codestorm1/mutebox_hat_audio_in/mutebox_hat_audio_in-JLCPCB Assembly Order.xls

JLCPCB BOM Tool - BOM Matching
BOM name：mutebox_hat_audio_in-JLCPCB Assembly Order.xlsx |  |  | Download Time：2026-02-12 05:37:34 |  |  |  | * Our matching results are updated in real-time, but stock and prices may change. If it's been over 24 hours, please re-match before placing your order.
PCB Assembled Qty：5 |  |  | Est. Total Price：35.0635
Your BOM |  |  |  |  | Matched Parts |  |  |  |  |  |  | Order Information
Top Designator | Bottom Designator | Comment | Footprint | JLCPCB Part # | Matches | Part # | Manufacturer | Footprint | Description | Category | Warning | JLCPCB Part # | Product link | Lib Type | Qty | Source | Total Price ($)
C2,C3,C12 |  | 100nF | Capacitor_SMD:C_0805_2012Metric_Pad1.18x1.45mm_HandSolder |  | Select by System | CC0603KRX7R9BB104 | YAGEO | 0603 | 100nF 50V X7R ±10% 0603 Multilayer Ceramic Capacitors MLCC - SMD/SMT ROHS | Multilayer Ceramic Capacitors MLCC - SMD/SMT |  | C14663 | https://jlcpcb.com/partdetail/YAGEO-CC0603KRX7R9BB104/C14663 | Basic | 15 | 15 JLCPCB | 0.039
C4 |  | 68nF | Capacitor_SMD:C_0805_2012Metric_Pad1.18x1.45mm_HandSolder |  | Select by System | CC0805KRX7R9BB683 | YAGEO | 0805 | 50V 68nF X7R ±10% 0805 Multilayer Ceramic Capacitors MLCC - SMD/SMT ROHS | Multilayer Ceramic Capacitors MLCC - SMD/SMT |  | C107159 | https://jlcpcb.com/partdetail/YAGEO-CC0805KRX7R9BB683/C107159 | Extended | 20 | 20 JLCPCB | 0.15
C5 |  | 4.7nF | Capacitor_SMD:C_0805_2012Metric_Pad1.18x1.45mm_HandSolder |  | Select by System | CC0805KRX7R9BB472 | YAGEO | 0805 | 4.7nF 50V X7R ±10% 0805 Multilayer Ceramic Capacitors MLCC - SMD/SMT ROHS | Multilayer Ceramic Capacitors MLCC - SMD/SMT |  | C107153 | https://jlcpcb.com/partdetail/YAGEO-CC0805KRX7R9BB472/C107153 | Extended | 20 | 20 JLCPCB | 0.12
C8,C9 |  | 1uF | Capacitor_SMD:C_0805_2012Metric_Pad1.18x1.45mm_HandSolder |  | Select by System | CL21B105KBFNNNE | Samsung Electro-Mechanics | 0805 | 1uF 50V X7R ±10% 0805 Multilayer Ceramic Capacitors MLCC - SMD/SMT ROHS | Multilayer Ceramic Capacitors MLCC - SMD/SMT |  | C28323 | https://jlcpcb.com/partdetail/29074-CL21B105KBFNNNE/C28323 | Basic | 10 | 10 JLCPCB | 0.099
C10 |  | 10uF | Capacitor_SMD:C_0805_2012Metric_Pad1.18x1.45mm_HandSolder |  | Select by System | CL21A106KAYNNNE | Samsung Electro-Mechanics | 0805 | 10uF 25V X5R ±10% 0805 Multilayer Ceramic Capacitors MLCC - SMD/SMT ROHS | Multilayer Ceramic Capacitors MLCC - SMD/SMT |  | C15850 | https://jlcpcb.com/partdetail/16532-CL21A106KAYNNNE/C15850 | Basic | 5 | 5 JLCPCB | 0.079
FB1 |  | FerriteBead | Inductor_SMD:L_0805_2012Metric_Pad1.05x1.20mm_HandSolder |  | Select by System | BLM21PG221SN1D | Murata Electronics | 0805 | 1 220Ω@100MHz 2A 45mΩ ±25% 0805 Ferrite Beads ROHS | Ferrite Beads |  | C85840 | https://jlcpcb.com/partdetail/MurataElectronics-BLM21PG221SN1D/C85840 | Extended | 20 | 20 JLCPCB | 0.332
R3,R4,R5,R6 |  | 10k | Resistor_SMD:R_0805_2012Metric_Pad1.20x1.40mm_HandSolder |  | Unconfirmed | RC0805FR-0710KL | YAGEO | 0805 | -55℃~+155℃ 10kΩ 125mW 150V Thick Film Resistor ±1% ±100ppm/℃ 0805 Chip Resistor - Surface Mount ROHS | Chip Resistor - Surface Mount | 1.Multiple lines in the BOM have been matched to the same part. Please check if the matching is correct. ; | C84376 | https://jlcpcb.com/partdetail/YAGEO-RC0805FR0710KL/C84376 | Extended | 35 | 35 JLCPCB | 0.0805
R7 |  | 10K | Resistor_SMD:R_0805_2012Metric_Pad1.20x1.40mm_HandSolder |  | Unconfirmed | RC0805FR-0710KL | YAGEO | 0805 | -55℃~+155℃ 10kΩ 125mW 150V Thick Film Resistor ±1% ±100ppm/℃ 0805 Chip Resistor - Surface Mount ROHS | Chip Resistor - Surface Mount | 1.Multiple lines in the BOM have been matched to the same part. Please check if the matching is correct. ; | C84376 | https://jlcpcb.com/partdetail/YAGEO-RC0805FR0710KL/C84376 | Extended | 35 | 35 JLCPCB | 0.0805
R8,R11,R20,R21 |  | 100k | Resistor_SMD:R_0805_2012Metric_Pad1.20x1.40mm_HandSolder |  | Unconfirmed | 0805W8F1003T5E | UNI-ROYAL(Uniroyal Elec) | 0805 | -55℃~+155℃ 100kΩ 125mW 150V Thick Film Resistor ±1% ±100ppm/℃ 0805 Chip Resistor - Surface Mount ROHS | Chip Resistor - Surface Mount | 1.The comment (0805W8F1003T5E) of this part does not match the one (100k) provided in your BOM. Please confirm; | C149504 | https://jlcpcb.com/partdetail/160838-0805W8F1003T5E/C149504 | Basic | 20 | 20 JLCPCB | 0.04
R9,R10 |  | 4.7k | Resistor_SMD:R_0805_2012Metric_Pad1.20x1.40mm_HandSolder |  | Select by System | 0805W8F4701T5E | UNI-ROYAL(Uniroyal Elec) | 0805 | -55℃~+155℃ 125mW 150V 4.7kΩ Thick Film Resistor ±1% ±100ppm/℃ 0805 Chip Resistor - Surface Mount ROHS | Chip Resistor - Surface Mount |  | C17673 | https://jlcpcb.com/partdetail/18361-0805W8F4701T5E/C17673 | Basic | 10 | 10 JLCPCB | 0.019
R12 |  | 680 | Resistor_SMD:R_0805_2012Metric_Pad1.20x1.40mm_HandSolder |  | Select by System | 680 | Keystone | - | - Ring Terminal ROHS | Cold-Pressed Terminals |  | C238151 | https://jlcpcb.com/partdetail/Keystone-680/C238151 | Extended | 0 | 0 JLCPCB | 0
R14 |  | 33 | Resistor_SMD:R_0805_2012Metric_Pad1.20x1.40mm_HandSolder |  | Select by System | RC0402FR-0733RL | YAGEO | 0402 | -55℃~+155℃ 33Ω 50V 62.5mW Thick Film Resistor ±1% ±100ppm/℃ 0402 Chip Resistor - Surface Mount ROHS | Chip Resistor - Surface Mount |  | C138002 | https://jlcpcb.com/partdetail/YAGEO-RC0402FR0733RL/C138002 | Extended | 20 | 20 JLCPCB | 0.016
U2 |  | 74LVC157 | Package_SO:SOIC-16_3.9x9.9mm_P1.27mm |  | Select by System | SN74LVC157ADR | Texas Instruments | SOIC-16-150mil | -40℃~+85℃ 24mA 24mA 2V~3.6V 40uA 5.2ns@3.3V,50pF Single Supply SOIC-16-150mil Signal Switches, Multiplexers, Decoders ROHS | Signal Switches, Multiplexers, Decoders |  | C7664 | https://jlcpcb.com/partdetail/TexasInstruments-SN74LVC157ADR/C7664 | Extended | 5 | 5 JLCPCB | 0.83
U5 |  | DIR9001PW | DIR9001_newfoot:PW28-M |  | Select by System | DIR9001PWR | Texas Instruments | TSSOP-28 | -40℃~+85℃ 2.7V~3.6V 28kHz~108kHz I2S Receiver TSSOP-28 Audio Interface ICs ROHS | Audio Interface ICs |  | C96215 | https://jlcpcb.com/partdetail/TexasInstruments-DIR9001PWR/C96215 | Extended | 5 | 5 JLCPCB | 6.876
Y3 |  | XO32 | Oscillator:Oscillator_SMD_EuroQuartz_XO32-4Pin_3.2x2.5mm |  | Select by System | ASE-24.576MHZ-LC-T | Abracon LLC | SMD3225-4P | -40℃~+85℃ 13mA 24.576MHz 3.3V ±50ppm SMD3225-4P Crystal Oscillators ROHS | Global Sourcing Parts |  | C6159263 | https://jlcpcb.com/partdetail/AbraconLLC-ASE_24_576MHZ_LCT/C6159263 | Extended | 9 | 9 JLCPCB | 26.3025
D1,D2 |  | APA102 | LED_SMD:LED_RGB_5050-6 |  | Select by System | APA102-2020 SuperLED | Led-Color | SMD-6P,2x2mm | SMD-6P,2x2mm RGB LEDs ROHS | Others |  | C22439302 | https://jlcpcb.com/partdetail/LedColor-APA102_2020SuperLED/C22439302 | Extended | 14 | 0 JLCPCB | 0
U3 |  | PCM1862DBT | Package_SO:TSSOP-30_6.1x9.7mm_P0.65mm |  | Select by System | PCM1862DBT | Texas Instruments | TSSOP-30 | -40℃~+125℃ 103dB 1MHz~50MHz 2 2.1V 24 3.3V 32kHz 353uA Built-in External、Built-in SPI、I2C Support Yes TSSOP-30 Analog to Digital Converters (ADC) ROHS | Analog To Digital Converters (ADCs) |  | C206108 | https://jlcpcb.com/partdetail/TexasInstruments-PCM1862DBT/C206108 | Extended | 5 | 0 JLCPCB | 0
