codestorm1/mutebox_hat_audio_in/mutebox_hat_audio_in.kicad_pcb

## KiCad design mutebox_hat_audio_in.kicad_pcb (2026-03-16)

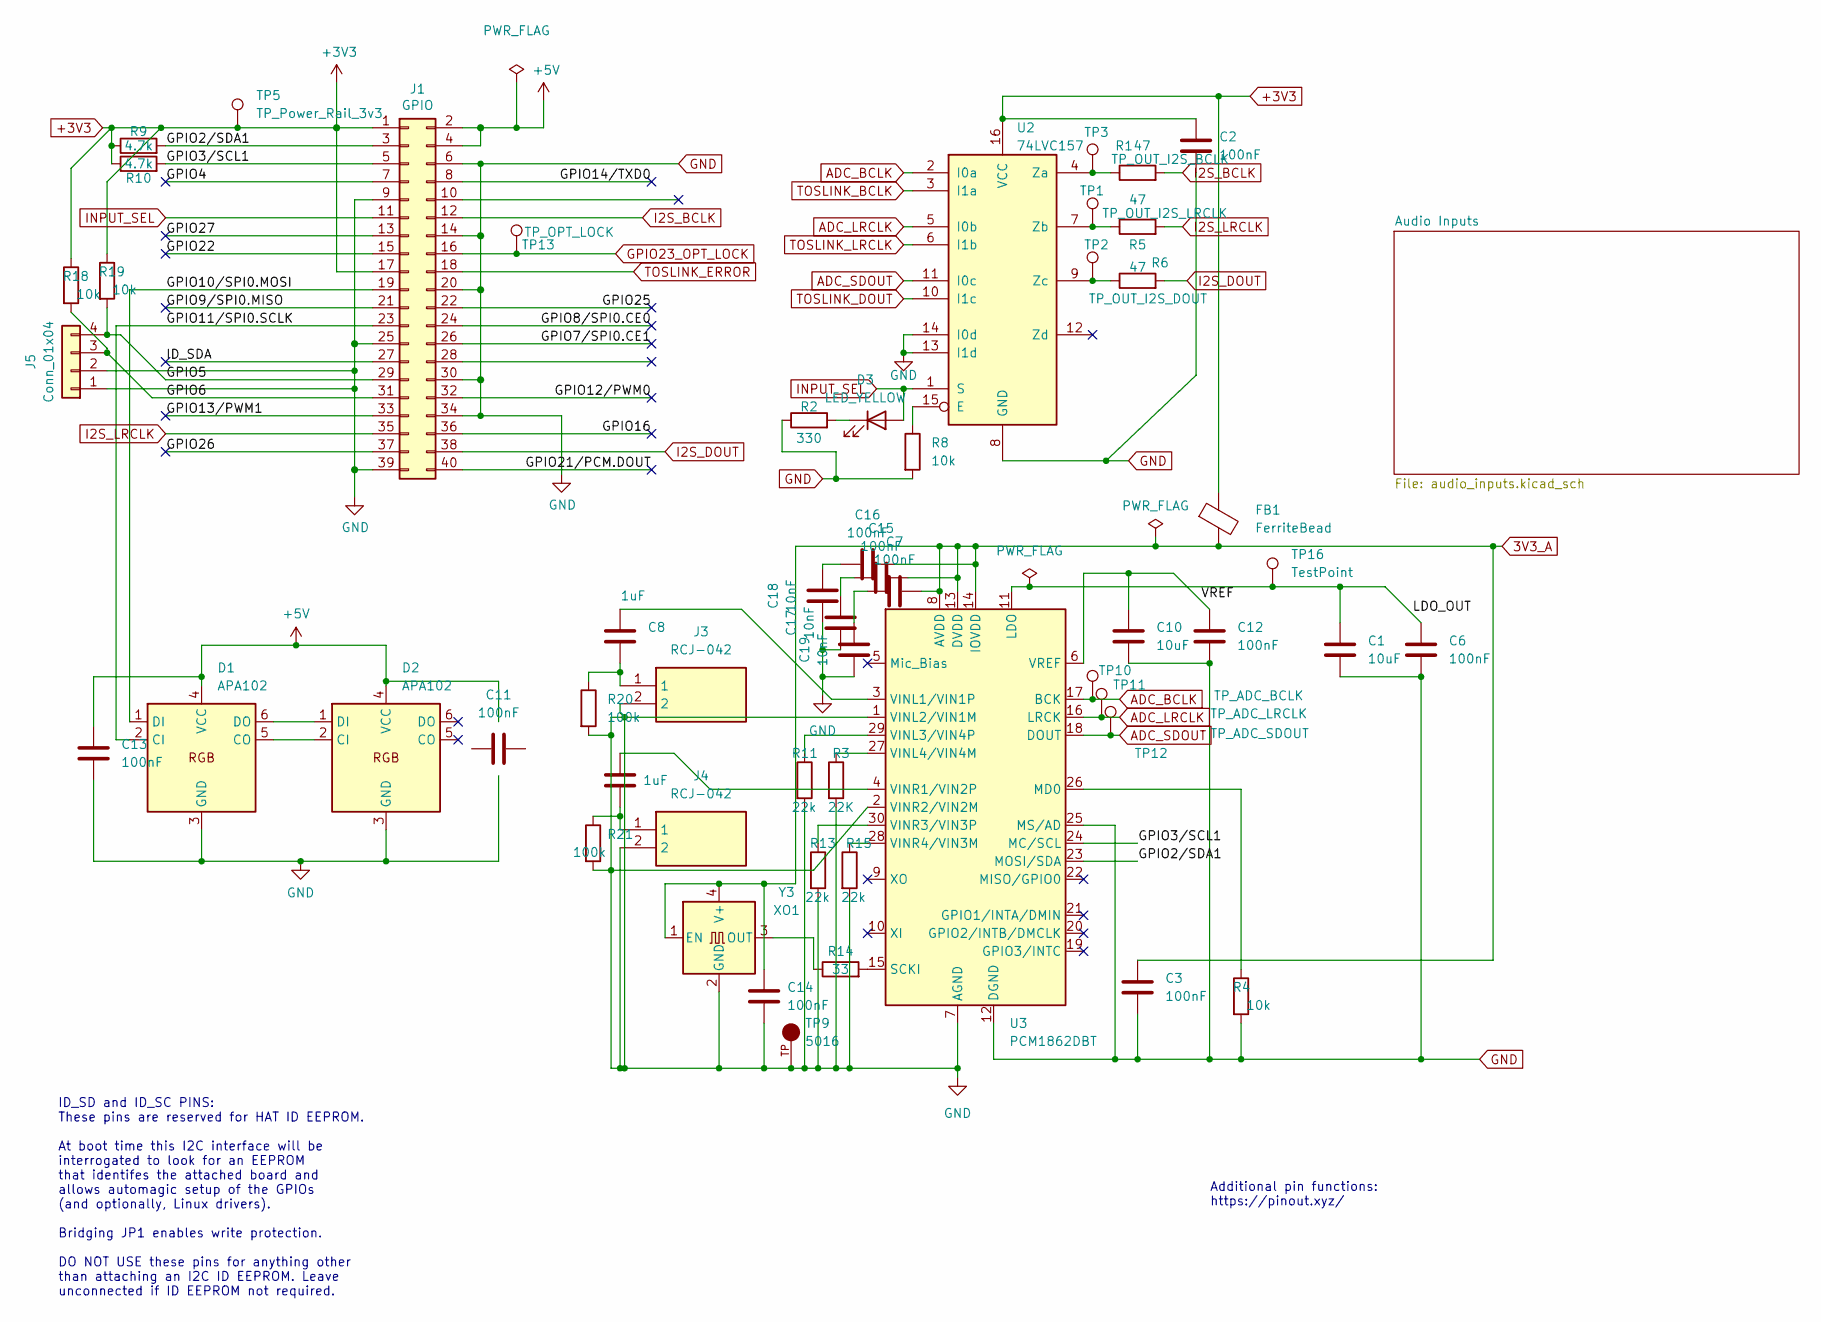
[picture p1: schematic mutebox_hat_audio_in.kicad_sch]

Parts:
C1, C10: 10uF; C_0402_1005Metric; LCSC C440198
C2, C3: 100nF; C_0805_2012Metric; LCSC C17414
C6, C7, C12, C15, C16: 100nF; C_0402_1005Metric; LCSC C1525
C8: 1uF; C_0402_1005Metric; LCSC C14445
C9: 1uF; C_0805_2012Metric; LCSC C14445
C11, C13: 100nF; C_0805_2012Metric; LCSC C1711
C14: 100nF; C_0402_1005Metric
C17, C18, C19: 10nF; C_0402_1005Metric; LCSC C15195
D1, D2: APA102; LED_RGB_5050-6; LCSC C5378730
D3: LED_YELLOW; LED_0402_1005Metric; LCSC C136118
FB1: FerriteBead; L_0805_2012Metric_Pad1.05x1.20mm_HandSolder; LCSC C85840
J1: GPIO; PinSocket_2x20_P2.54mm_Vertical
J3, J4: RCJ-042; CUI_RCJ-042; Manufacturer_Part_Number RCJ-042; Mouser Part Number 490-RCJ-042
J5: Conn_01x04; PinHeader_1x04_P2.54mm_Vertical
R1, R5, R6: 47; R_0402_1005Metric; LCSC C413056
R2: 330; R_0805_2012Metric; LCSC C17471
R3: 22K; R_0402_1005Metric; LCSC C2909337
R4, R8: 10k; R_0805_2012Metric; LCSC C17414
R9, R10: 4.7k; R_0805_2012Metric; LCSC C17673
R11, R13, R15: 22k; R_0402_1005Metric; LCSC C2909337
R14: 33; R_0402_1005Metric; LCSC C17634
R18, R19: 10k; R_0402_1005Metric; LCSC C17414
R20, R21: 100k; R_0402_1005Metric; LCSC C149504
TP1: TP_OUT_I2S_LRCLK; TestPoint_Pad_D1.0mm
TP2: TP_OUT_I2S_DOUT; TestPoint_Pad_D1.0mm
TP3: TP_OUT_I2S_BCLK; TestPoint_Pad_D1.0mm
TP5: TP_Power_Rail_3v3; TestPoint_Pad_D1.0mm
TP9: 5016; KEYSTONE_5016; PARTREV D
TP10: TP_ADC_BCLK; TestPoint_Pad_D1.0mm
TP11: TP_ADC_LRCLK; TestPoint_Pad_D1.0mm
TP12: TP_ADC_SDOUT; TestPoint_Pad_D1.0mm
TP13: TP_OPT_LOCK; TestPoint_Pad_D1.0mm
TP16: TestPoint; TestPoint_Pad_D1.0mm
U2: 74LVC157; SOIC-16_3.9x9.9mm_P1.27mm; LCSC C7664
U3: PCM1862DBT; DBT0030A_N; LCSC C544647
Y3: XO1; Oscillator_SMD_EuroQuartz_XO32-4Pin_3.2x2.5mm; LCSC C6159263

Connections:
3V3_A: C3.1, C7.2, C14.1, C15.2, C16.2, FB1.2, U3.8 (AVDD), U3.13 (DVDD), U3.14 (IOVDD), Y3.1 (EN), Y3.4 (V+)
+3V3: C2.1, FB1.1, J1.1, J1.17, R9.1, R10.1, R18.1, R19.1, TP5.1, U2.16 (VCC); also elsewhere on the board
+5V: C13.1, D1.4 (VCC), D2.4 (VCC), J1.2, J1.4
/GPIO2/SDA1: J1.3, R9.2, U3.23 (MOSI/SDA)
/GPIO3/SCL1: J1.5, R10.2, U3.24 (MC/SCL)
/GPIO4: J1.7
/GPIO5: J1.29, J5.4, R19.2
/GPIO6: J1.31, J5.3, R18.2
/GPIO7/SPI0.CE1: J1.26
/GPIO8/SPI0.CE0: J1.24
/GPIO9/SPI0.MISO: J1.21
/GPIO10/SPI0.MOSI: D1.1 (DI), J1.19
/GPIO11/SPI0.SCLK: D1.2 (CI), J1.23
/GPIO12/PWM0: J1.32
/GPIO13/PWM1: J1.33
/GPIO14/TXD0: J1.8
/GPIO16: J1.36
/GPIO21/PCM.DOUT: J1.40
/GPIO22: J1.15
/GPIO25: J1.22
/GPIO26: J1.37
/GPIO27: J1.13
/ID_SDA: J1.27
/LDO_OUT: C1.1, C6.1, TP16.1, U3.11 (LDO)
/VREF: C10.1, C12.1, U3.6 (VREF)
ADC_BCLK: TP10.1, U2.2 (I0a), U3.17 (BCK)
ADC_LRCLK: TP11.1, U2.5 (I0b), U3.16 (LRCK)
ADC_SDOUT: TP12.1, U2.11 (I0c), U3.18 (DOUT)
GND: C1.2, C2.2, C3.2, C6.2, C10.2, C12.2, C13.2, C14.2, C17.2, C18.2, C19.2, D1.3 (GND), D2.3 (GND), J1.6, J1.9, J1.14, J1.20, J1.25, J1.30, J1.34, J1.39, J3.2, J4.2, J5.1, J5.2, R2.1, R3.2, R4.2, R8.2, R11.2, R13.2, R15.2, R20.2, R21.2, TP9.TP, U2.8 (GND), U2.13 (I1d), U2.14 (I0d), U3.1 (VINL2/VIN1M), U3.2 (VINR2/VIN2M), U3.7 (AGND), U3.12 (DGND), U3.25 (MS/AD), Y3.2 (GND); also elsewhere on the board
GPIO23_OPT_LOCK: J1.16, TP13.1; also elsewhere on the board
I2S_BCLK: J1.12, R1.2
I2S_DOUT: J1.38, R6.2
I2S_LRCLK: J1.35, R5.2
INPUT_SEL: D3.2 (A), J1.11, U2.1 (S)
unnamed: C8.2, J3.1, R20.1
unnamed: C9.2, J4.1, R21.1
unnamed: C15.1, C17.1
unnamed: C16.1, C18.1
unnamed: C7.1, C19.1
unnamed: D1.5 (CO), D2.2 (CI)
unnamed: D1.6 (DO), D2.1 (DI)
unnamed: D3.1 (K), R2.2
unnamed: R8.1, U2.15 (E)
unnamed: R1.1, TP3.1, U2.4 (Za)
unnamed: R5.1, TP1.1, U2.7 (Zb)
unnamed: R6.1, TP2.1, U2.9 (Zc)
unnamed: R4.1, U3.26 (MD0)
unnamed: R14.2, U3.15 (SCKI)
unnamed: C8.1, U3.3 (VINL1/VIN1P)
unnamed: R11.1, U3.29 (VINL3/VIN4P)
unnamed: R3.1, U3.27 (VINL4/VIN4M)
unnamed: C9.1, U3.4 (VINR1/VIN2P)
unnamed: R13.1, U3.30 (VINR3/VIN3P)
unnamed: R15.1, U3.28 (VINR4/VIN3M)
unnamed: R14.1, Y3.3 (OUT)
TOSLINK_BCLK: U2.3 (I1a); also elsewhere on the board
TOSLINK_DOUT: U2.10 (I1c); also elsewhere on the board
TOSLINK_ERROR: J1.18; also elsewhere on the board
TOSLINK_LRCLK: U2.6 (I1b); also elsewhere on the board

Notes on the sheet:
Additional pin functions: https://pinout.xyz/
ID_SD and ID_SC PINS: These pins are reserved for HAT ID EEPROM. At boot time this I2C interface will be interrogated to look for an EEPROM that identifes the attached board and allows automagic setup of the GPIOs (and optionally, Linux drivers). Bridging JP1 enables write protection. DO NOT USE th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

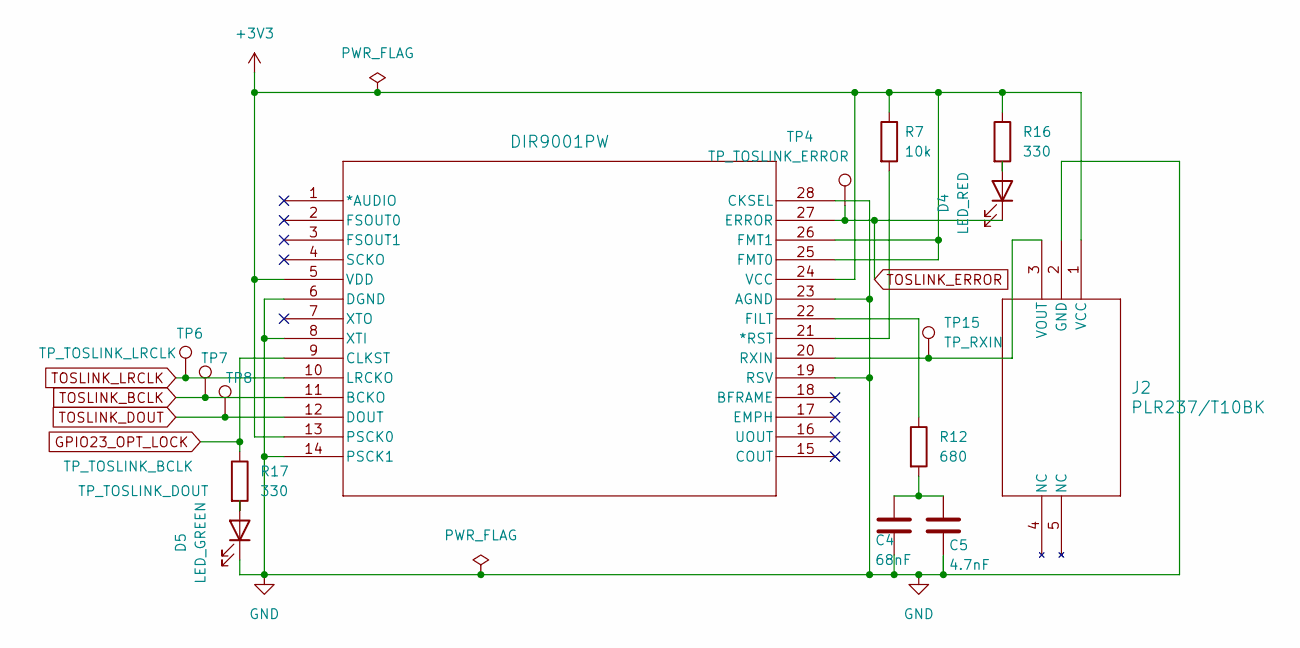
[picture p2: schematic audio_inputs.kicad_sch]

Parts:
C4: 68nF; C_0805_2012Metric; LCSC C107159
C5: 4.7nF; C_0805_2012Metric; LCSC C1744
D4: LED_RED; LED_0402_1005Metric; LCSC C71911
D5: LED_GREEN; LED_0402_1005Metric; LCSC C74338
J2: PLR237/T10BK; PLR237T10BK
R7: 10k; R_0805_2012Metric; LCSC C17414
R12: 680; R_0402_1005Metric; LCSC C156168
R16, R17: 330; R_0402_1005Metric; LCSC C1705212
TP4: TP_TOSLINK_ERROR; TestPoint_Pad_D1.0mm
TP6: TP_TOSLINK_LRCLK; TestPoint_Pad_D1.0mm
TP7: TP_TOSLINK_BCLK; TestPoint_Pad_D1.0mm
TP8: TP_TOSLINK_DOUT; TestPoint_Pad_D1.0mm
TP15: TP_RXIN; TestPoint_Pad_D1.0mm
U5: DIR9001PW; PW28-M; LCSC C96215

Connections:
+3V3: J2.1 (VCC), R7.1, R16.1, U5.5 (VDD), U5.13 (PSCK0), U5.24 (VCC), U5.25 (FMT0), U5.26 (FMT1); also elsewhere on the board
GND: C4.2, C5.2, D5.1 (K), J2.2 (GND), U5.6 (DGND), U5.8 (XTI), U5.14 (PSCK1), U5.19 (RSV), U5.23 (AGND), U5.28 (CKSEL); also elsewhere on the board
GPIO23_OPT_LOCK: R17.1, U5.9 (CLKST); also elsewhere on the board
unnamed: C4.1, C5.1, R12.2
unnamed: D4.2 (A), R16.2
unnamed: D5.2 (A), R17.2
unnamed: J2.3 (VOUT), TP15.1, U5.20 (RXIN)
unnamed: R7.2, U5.21 (*RST)
unnamed: R12.1, U5.22 (FILT)
TOSLINK_BCLK: TP7.1, U5.11 (BCKO); also elsewhere on the board
TOSLINK_DOUT: TP8.1, U5.12 (DOUT); also elsewhere on the board
TOSLINK_ERROR: D4.1 (K), TP4.1, U5.27 (ERROR); also elsewhere on the board
TOSLINK_LRCLK: TP6.1, U5.10 (LRCKO); also elsewhere on the board

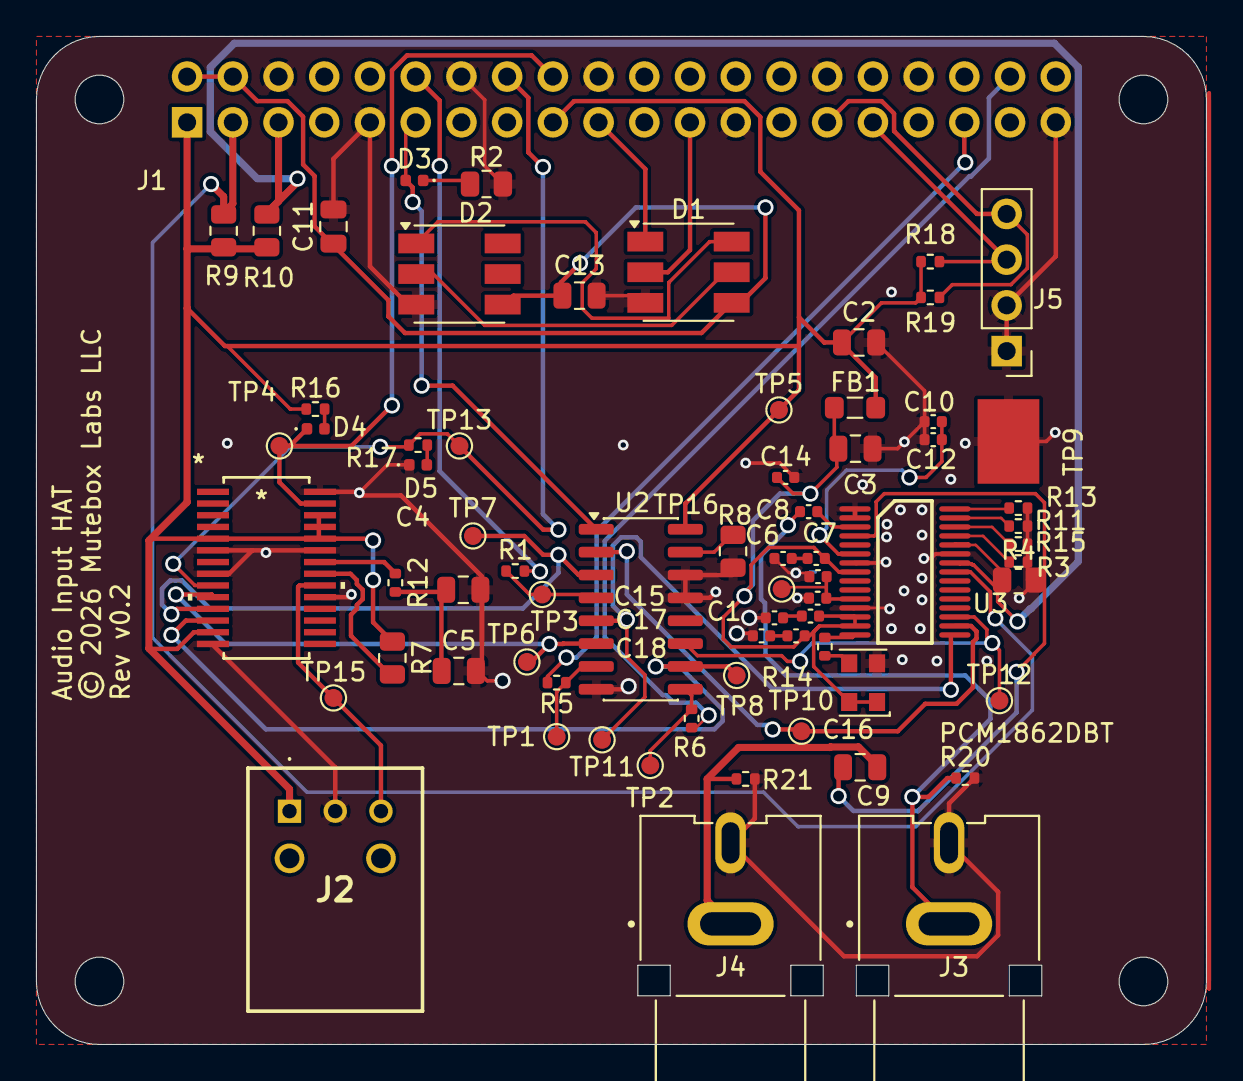
[picture p3: board mutebox_hat_audio_in.kicad_pcb from above]

Board: 2 copper layers, 65.0 x 56.0 mm, 74 parts (1 on the bottom side), 51 nets.

Other parts of the board:
MH1, MH2, MH3, MH4: MountingHole_2.7mm_M2.5
