codestorm1/mutebox_hat_audio_in/(commit log)

2025-12-30 Added WM8804 SPDIF support board.
    [audio_inputs.kicad_sch, mutebox_hat_audio_in.kicad_sch]
2025-12-30 Added PWR_FLAGs. Fixed some issues
    [audio_inputs.kicad_sch]
2025-12-30 schematic fixes
    [mutebox_hat_audio_in.kicad_sch]
2026-01-02 Some cleanup of schematic symbols etc.
2026-01-03 Added footprint assignments
    [audio_inputs.kicad_sch, mutebox_hat_audio_in.kicad_sch]
2026-01-03 Changes to footprints (?)
2026-01-04 switched to DIR9001PW for digital audio input
    [mutebox_hat_audio_in.kicad_pcb, mutebox_hat_audio_in.kicad_sch]
2026-01-04 visiually cleaned up DIR9000
    [audio_inputs.kicad_sch]
2026-01-04 Fixed some errors, like power connections
    [audio_inputs.kicad_sch, mutebox_hat_audio_in.kicad_sch]
2026-01-05 Fixed some connections and global labels
    [audio_inputs.kicad_sch, mutebox_hat_audio_in.kicad_sch]
2026-01-05 Fixed power/caps for TOSLINK. Got ERC down to warnings
    [audio_inputs.kicad_sch, mutebox_hat_audio_in.kicad_sch]
2026-01-05 Assigned footprints that were missing
    [audio_inputs.kicad_sch, mutebox_hat_audio_in.kicad_sch]
2026-01-05 Small tweaks, positioning. About to start PCB
    [mutebox_hat_audio_in.kicad_sch]
2026-01-05 Started on PCB
    [mutebox_hat_audio_in.kicad_pcb, mutebox_hat_audio_in.kicad_sch]
2026-01-05 Started positioning of components
    [mutebox_hat_audio_in.kicad_pcb]
2026-01-05 Laid out most components
    [mutebox_hat_audio_in.kicad_pcb]
2026-01-05 Added SPDIF/TOSLINK footprint
    [mutebox_hat_audio_in.kicad_pcb]
2026-01-05 Added new footprints for TOSLINK and RCA. Fixed outer edge. PCB ready to add routes.
    [audio_inputs.kicad_sch, mutebox_hat_audio_in.kicad_pcb]
2026-01-07 Added routes for crystal and part of toslink
    [audio_inputs.kicad_sch, mutebox_hat_audio_in.kicad_pcb, mutebox_hat_audio_in.kicad_sch]
2026-01-07 Got ground layers/fill zones done
    [mutebox_hat_audio_in.kicad_pcb]
2026-01-07 Added 3v3_a traces. rearranged some components
    [mutebox_hat_audio_in.kicad_pcb]
2026-01-08 Added trace routes/vias on the Back Copper plane
    [mutebox_hat_audio_in.kicad_pcb]
2026-01-09 Small route fixes
    [mutebox_hat_audio_in.kicad_pcb]
2026-01-10 Added better multiplexer setup
    [audio_inputs.kicad_sch, mutebox_hat_audio_in.csv, mutebox_hat_audio_in.kicad_sch]
2026-01-10 Changed DIN connections
    [audio_inputs.kicad_sch, mutebox_hat_audio_in.kicad_pcb, mutebox_hat_audio_in.kicad_sch]
2026-01-11 Fixed a bunch of schematic issues
    [audio_inputs.kicad_sch, mutebox_hat_audio_in.kicad_sch]
2026-01-11 More routing on PCB
    [audio_inputs.kicad_sch, mutebox_hat_audio_in.kicad_pcb, mutebox_hat_audio_in.kicad_sch]
2026-01-11 Fixed all routes but TOSLINK footprint
    [mutebox_hat_audio_in.kicad_pcb]
2026-01-11 More route cleanup on PCB
2026-01-11 Fixed footprint for ADC chip (PCM1862). Fixed more issues.
    [mutebox_hat_audio_in.kicad_pcb, mutebox_hat_audio_in.kicad_sch]
2026-01-12 Added symbol and footprint for PLR237/T10BK Toslink
    [mutebox_hat_audio_in.kicad_pcb]
2026-01-12 Fixed RCA Jack symbols and footprints
    [audio_inputs.kicad_sch, mutebox_hat_audio_in.kicad_pcb, mutebox_hat_audio_in.kicad_sch]
2026-01-12 fixed cooper fill zone issue. Fixed broken routes
    [audio_inputs.kicad_sch, mutebox_hat_audio_in.kicad_pcb, mutebox_hat_audio_in.kicad_sch]
2026-01-12 PCB tweaks
    [mutebox_hat_audio_in.kicad_pcb]
2026-01-13 Fixed all DRC errors
    [mutebox_hat_audio_in.csv, mutebox_hat_audio_in.kicad_pcb]
2026-02-04 Fixed inconsistencies in footprints and names
    [audio_inputs.kicad_sch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]
2026-02-07 Replaced footprint for DIR9001PW
    [mutebox_hat_audio_in.kicad_pcb]
2026-02-07 Removed unneeded crystal for DIR9001PW
    [audio_inputs.kicad_sch, mutebox_hat_audio_in.kicad_pcb]
2026-02-09 Updated schematic with correct symbol for DIR9001PW
    [audio_inputs.kicad_sch, mutebox_hat_audio_in.kicad_pcb, mutebox_hat_audio_in.kicad_sch]
2026-02-09 Progress updating to correct footprint for DIR9001PW chip
    [audio_inputs.kicad_sch, mutebox_hat_audio_in.kicad_pcb]
2026-02-09 Fixed problems with zone fills and general PCB hell
    [mutebox_hat_audio_in.kicad_pcb, mutebox_hat_audio_in.kicad_sch]
2026-02-11 Fixed remaining issues. Sent to production house
    [audio_inputs.kicad_sch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]
2026-02-12 Fixed 620 ohm resistor to 680. Added parts for dotstart lights. Added LCSC part numbers to components
    [audio_inputs.kicad_sch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]
2026-02-28 minor changes. Rev 0.1a in a recent build
    [audio_inputs.kicad_sch, mutebox_hat_audio_in.kicad_sch]
2026-02-28 Fixed traves on oscillator
    [mutebox_hat_audio_in.kicad_sch]
2026-02-28 Added testpoint with large clip on footprint
    [mutebox_hat_audio_in.kicad_pcb]
2026-03-01 Fixed dotstar positioning. Minor changes to PCB
    [audio_inputs.kicad_sch, mutebox_hat_audio_in.kicad_pcb, mutebox_hat_audio_in.kicad_sch]
2026-03-01 Added LED for OPT LOCK
    [mutebox_hat_audio_in.kicad_pcb, mutebox_hat_audio_in_today.csv]
2026-03-01 Rewired MS to 3v3a instead of GND
    [mutebox_hat_audio_in.kicad_sch]
2026-03-01 Fixed PCB for MODE_MS
    [mutebox_hat_audio_in.kicad_pcb]
2026-03-01 Moved dotstar caps to front of board.
    [mutebox_hat_audio_in.kicad_pcb, mutebox_hat_audio_in.kicad_sch]
2026-03-02 Fixed RCA Jack LCSC part numbers
    [mutebox_hat_audio_in.kicad_sch]
2026-03-02 Final changes before ordering.
    [audio_inputs.kicad_sch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]
2026-03-03 Starting on version v0.1c
    [mutebox_hat_audio_in.kicad_pcb]
2026-03-03 Fixed missing connection from RPi4 to dotstar LED
    [mutebox_hat_audio_in.kicad_sch]
2026-03-12 Fixed unconnected trace
    [mutebox_hat_audio_in.kicad_pcb]
2026-03-13 Changed MS/AD (pin 25) to go to GND for default address 0x4A
    [mutebox_hat_audio_in.kicad_pcb, mutebox_hat_audio_in.kicad_sch]
2026-03-13 Running pins 27-30 to ground through 100k resistors
    [mutebox_hat_audio_in.kicad_sch]
2026-03-14 Added small LEDs for DIR lock status/error
    [mutebox_hat_audio_in.kicad_pcb, mutebox_hat_audio_in.kicad_sch]
2026-03-15 Cleaned up a lot around the PCM1862. ADC side looking pretty good
    [audio_inputs.kicad_sch, mutebox_hat_audio_in.kicad_pcb]
2026-03-15 Removed 3v3 rail going across the board. Rotated dotstars to put pin 1 upper left.
    [audio_inputs.kicad_sch, mutebox_hat_audio_in.kicad_pcb, mutebox_hat_audio_in.kicad_sch]
2026-03-15 Fixed DRC issues
    [mutebox_hat_audio_in.kicad_pcb]
2026-03-15 Board fixes. Nearly ready for a production test run
    [mutebox_hat_audio_in.kicad_sch]
2026-03-15 Filled zones
    [mutebox_hat_audio_in.kicad_pcb, mutebox_hat_audio_in.kicad_sch]
2026-03-16 Final changes for production run
    [audio_inputs.kicad_sch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]
