codestorm1/mutebox_hat_audio_in/(notices)

Notices in the files:
mutebox_hat_audio_in.kicad_pcb:
© 2026 Mutebox Labs LLC
